AnkhC1/rover-project/README.md

# Autonomous SLAM Rover

**A ground-up autonomous mobile robot** — ESP32 firmware, LiDAR-based SLAM, and Nav2 path planning, integrated on hobby-grade hardware with no operating system on the embedded side.

`ESP32` `micro-ROS` `ROS 2 Kilted` `SLAM Toolbox` `Nav2 / MPPI` `C++` `Python`

[Demo video](https://youtube.com/shorts/VPZTrOBSdS8?feature=share) — shows the rover failing to navigate around an obstacle due to dropped scans and timestamp mismatch; see Known Limitations below · [Chassis CAD (Onshape)](https://cad.onshape.com/documents/83125d1df7da4e076211cfb5/w/6ad0806186d95563e5e967b6/e/4eaaa43f1ce4cf23ad352b7c)

---

## Overview

This rover maps unknown indoor environments in real time using 2D LiDAR SLAM, with a Nav2/MPPI autonomous navigation stack layered on top. The embedded platform is heavily constrained: an ESP32 microcontroller — no OS, WiFi-only, limited compute — bridged to a full ROS 2 navigation stack over `micro-ROS`. A Raspberry Pi would have sidestepped most of the hardest problems in this project; the ESP32 forced real engineering around clock synchronization, wireless message loss, and firmware-level motor control that a more capable board would have hidden.

The chassis was independently designed to mate with [SnappyXO](https://snappyxo.com/) — a modular hardware kit of laser-cut Delrin beams, plates, and connectors developed at Stony Brook University to teach the engineering design process — so the rover's structure builds directly from those components rather than one-off custom parts.

**SLAM mapping is solid** (10 Hz on both `/scan` and `/odom`, σ ≈ 0.05 Hz, coherent occupancy grids). **Autonomous navigation is implemented but not yet validated** — every navigation test to date has run concurrently with live SLAM rather than against a completed, static map, which conflates two separate failure domains and makes root-causing harder. That gap, and the debugging work that led to finding it, is documented below.

## System Architecture

```mermaid
graph LR
    subgraph ESP32["ESP32 (Firmware — C++/Arduino, no OS)"]
        LIDAR[RPLidar C1<br/>UART 460800 baud]
        SERVO[STS3215 Servo Bus<br/>Half-duplex UART 1Mbaud]
        ODOM[Odometry Calc<br/>10 Hz]
        CLK[Clock Sync<br/>every 1-2s]
    end

    subgraph HOST["ROS 2 Kilted Host"]
        AGENT[micro-ROS Agent]
        EKF[robot_localization EKF<br/>~13.5 Hz]
        SLAM[SLAM Toolbox<br/>async]
        NAV[Nav2: MPPI Controller<br/>+ Planner + Costmaps]
    end

    LIDAR -->|LaserScan @5Hz| ESP32
    SERVO --> ODOM
    ESP32 <-->|WiFi/UDP| AGENT
    AGENT --> EKF --> SLAM --> NAV
    NAV -->|cmd_vel chain| AGENT
    AGENT -->|Twist| SERVO
```

## Engineering Challenges

Four problems that best represent the actual debugging work on this project — root cause, fix, and reasoning for each.

### 1. Controller loop silently running at 2 Hz instead of 10 Hz
- **Symptom:** Navigation was sluggish and oscillated near goals — the robot consistently overshot turns before correcting.
- **Diagnosis:** Traced the full `cmd_vel` pipeline with `ros2 topic hz` at each hop (`controller_server → cmd_vel_nav → velocity_smoother → cmd_vel_smoothed → collision_monitor → cmd_vel`) and found messages dying between two nodes.
- **Root cause:** ROS 2 Kilted defaults `behavior_server` to `TwistStamped`, while the ESP32 firmware subscribed to plain `Twist`. Both message types were present on the same topic; ROS 2 subscribers reject mismatched types silently — no error, no warning, just missing messages.
- **Fix:** Set `enable_stamped_cmd_vel: false` across all velocity-publishing nodes to force a consistent type through the entire chain.

### 2. Asymmetric wheel speeds from a firmware-level bug
- **Symptom:** The rover drifted during commands that should have driven it straight.
- **Diagnosis:** Isolated the fault to the motor driver layer rather than kinematics or odometry by commanding raw wheel speeds directly and observing the asymmetry persist.
- **Root cause:** The Feetech STS servo library's `WriteSpe()` expects a signed 16-bit integer for direction encoding. An earlier implementation manually manipulated the sign bit instead, corrupting speed commands in a way that only showed up as inconsistent — not obviously wrong — motion.
- **Fix:** Replaced manual bit manipulation with correct signed-integer calls.

### 3. Stale transforms from ESP32↔host clock drift (up to 592ms)
- **Symptom:** Intermittent `TF extrapolation error` and Nav2's error 102 ("unable to transform goal into costmap frame"), especially during in-place rotation.
- **Diagnosis:** An embedded microcontroller with no OS and no NTP-equivalent drifts against the host clock. That drift invalidated timestamps used by SLAM and TF lookups.
- **Fix:** Increased `transform_tolerance` to 1.0s across every Nav2 component *and* every costmap (they perform independent TF lookups with their own default tolerances), and increased ESP32 clock re-sync frequency via `rmw_uros_sync_session()`. Both were necessary — tolerance absorbs transient drift, faster sync prevents accumulation.

### 4. Effective track width diverging from physical measurement
- **Symptom:** Odometry-based heading was consistently wrong despite correct physical wheel spacing.
- **Diagnosis:** Commanded a 1080° (3-rotation) spin-in-place test and measured actual angle turned, isolating pure kinematic error from lag-induced error (a single-rotation test conflates the two).
- **Root cause:** Wheel slip during in-place rotation on hard flooring means the *effective* kinematic track width is larger than the physically measured wheel-to-wheel distance — expected behavior for differential drive, but only quantifiable empirically.
- **Fix:** Scaled `TRACK_WIDTH` proportionally (`new = old × actual_angle / commanded_angle`) from 0.18m to 0.1875m, confirmed by re-running the test.

*A full issue-and-resolution log covering 15+ additional bugs across odometry, SLAM Toolbox tuning, and Nav2 parameter configuration is in [`/docs/postmortem.pdf`](./docs/postmortem.pdf).*

## Current Status & Known Limitations

| Component | Status |
|---|---|
| SLAM Mapping | Stable — 10 Hz publish rate on `/scan` and `/odom` (σ ≈ 0.05 Hz), coherent occupancy grids |
| Odometry / EKF | Empirically calibrated, fused via `robot_localization`, stable under teleop |
| Autonomous Navigation | Nav2/MPPI stack implemented and issuing collision-free local trajectories in isolated tests — **not yet validated end-to-end** |

**Known limitation:** every autonomous navigation test so far has run concurrently with live SLAM, rather than against a completed, static map. Running both at once contends for the ESP32's limited compute and worsens clock drift between scans, which conflates two distinct failure domains — mapping/localization error vs. navigation-stack timing — and makes it hard to tell which one caused a given failure. The linked demo video shows the result: the rover fails to navigate around an obstacle due to dropped scans and a timestamp mismatch. Isolating these two phases (build a map first, localize against it, *then* run navigation) is the top item under Future Work below.

## Repository Structure

- `main` — mapping-only functionality
- `nav2-integration` — Nav2/MPPI navigation stack integrated on top of live SLAM (see Known Limitations above)

## Hardware

| Component | Spec |
|---|---|
| Compute | ESP32-S (NodeMCU form factor) |
| LiDAR | RPLidar C1, 360°, up to 12m, UART @ 460800 baud |
| Actuation | 2× Feetech STS3215 serial bus servos, differential drive |
| Power | 5V/3A bank (logic/LiDAR), 2S 18650 7.4V pack (servo bus) |

## Future Work

- Validate navigation against a completed, static map (build map → localize-only → navigate) instead of running concurrently with live SLAM, to isolate localization drift from navigation-stack timing issues
- Migrate to Raspberry Pi 4 to eliminate the WiFi/clock-drift problem class entirely and free compute headroom for SLAM + Nav2 + MPPI running concurrently, if concurrent operation is still needed
- IMU fusion into the EKF to reduce rotational odometry error from wheel slip
- Direct quadrature encoder feedback in place of servo absolute-position polling

## Setup

Full installation, wiring, and build instructions are in [`/docs/postmortem.pdf`](./docs/postmortem.pdf) (§6). Requires ROS 2 Kilted on Ubuntu 24.04, Arduino IDE 2.3.4, and the micro-ROS Arduino library.
