AnkhC1/rover-project/rover_ws/src/rover_bringup/urdf/rover.urdf

<?xml version="1.1"?>
<robot name="rover">

  <link name="base_footprint"/>

  <link name="base_link"/>

  <joint name="base_footprint_to_base" type="fixed">
    <parent link="base_footprint"/>
    <child link="base_link"/>
    <origin xyz="0 0 0" rpy="0 0 0"/>
  </joint>

  <link name="laser_frame"/>

  <joint name="base_to_laser" type="fixed">
    <parent link="base_link"/>
    <child link="laser_frame"/>
    <origin xyz="0.075 0 0.1365" rpy="0 0 0"/>
  </joint>

  <link name="left_wheel">
    </link>

  <joint name="base_to_left_wheel" type="continuous">
    <parent link="base_link"/>
    <child link="left_wheel"/>
    <origin xyz="0 0.09375 0" rpy="-1.5708 0 0"/> 
    <axis xyz="0 0 1"/>
  </joint>

  <link name="right_wheel">
    </link>

  <joint name="base_to_right_wheel" type="continuous">
    <parent link="base_link"/>
    <child link="right_wheel"/>
    <origin xyz="0 -0.09375 0" rpy="-1.5708 0 0"/>
    <axis xyz="0 0 1"/>
  </joint>

</robot>
