AnkhC1/rover-project/(commit log)

2026-03-25 Initial commit: ESP32 sketch, uros_ws and rover_ws source files; Current bug with frequency and SLAM functionality
    [rover.urdf]
2026-04-23 Adjusted wheel track and lidar height
    [rover.urdf]
2026-04-24 Reduced path angle and prefer forward critic weights. increased SLAM transform timeout, minimum travel heading, and loop match minimum; decreased map update interval and added minimum time interval.
    [rover.urdf]
2026-04-27 adjusted various frequencies in nav2 params and fixed bitwise motor logic
    [esp32-rover.ino]
